GadgetReboot/USB_RS485/GR_USB_RS485_Sch.pdf

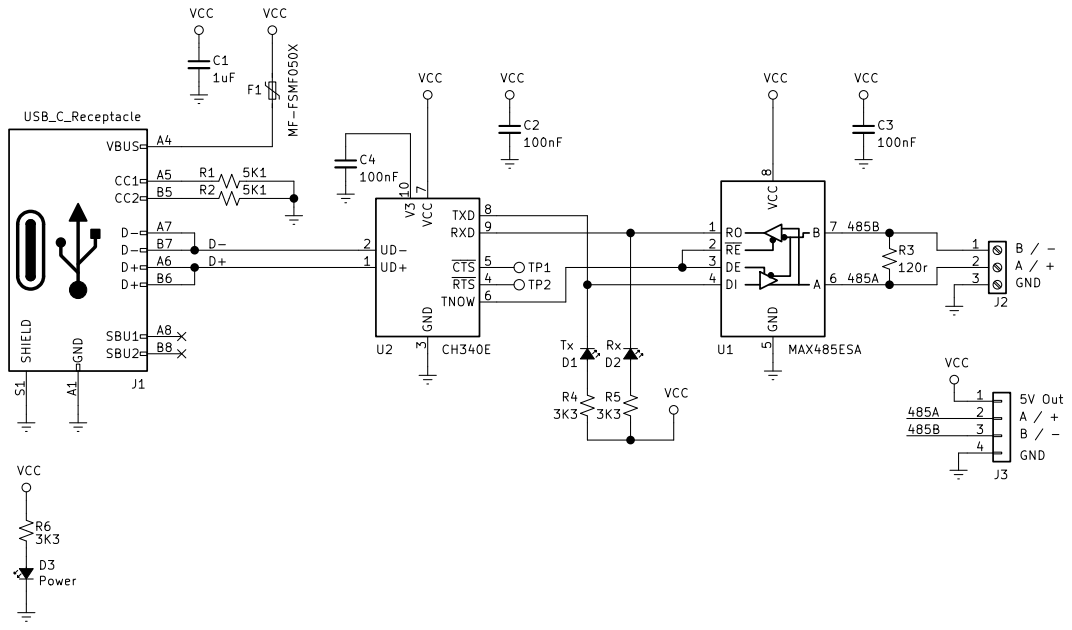
[picture p1: page 1]

7 TXD 8 RXD 9 U2 CH340E RO 1 RE 2 DE 3 DI 4 GND

3 RTS 4 CTS 5 TNOW 6 VCC

https://github.com/GadgetReboot/USB_RS485
https://www.youtube.com/gadgetreboot
File: GR_USB_RS485.sch Sheet: / Gadget Reboot

Id: 1/1 Title: USB to RS485
