GadgetReboot/USB_RS485/KiCad/GR_USB_RS485.kicad_pcb

## KiCad design KiCad/GR_USB_RS485.kicad_pcb (2023-02-17)

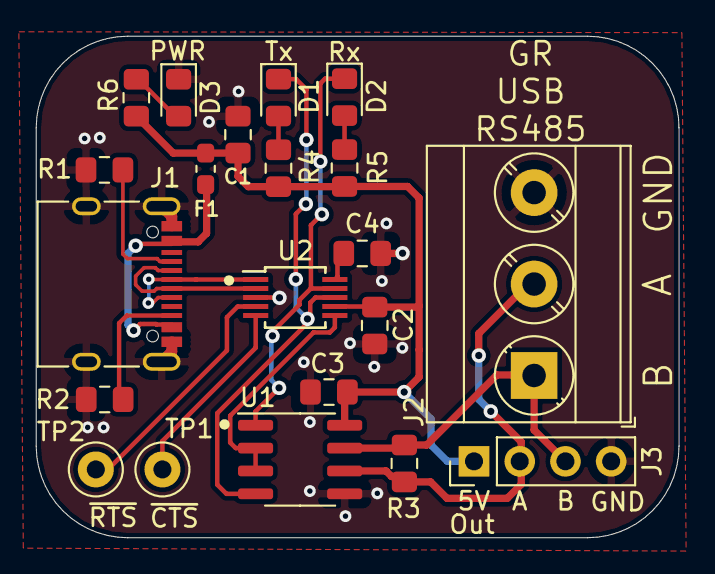
[picture p2: board GR_USB_RS485.kicad_pcb from above]

Board: 2 copper layers, 35.7 x 27.9 mm, 21 parts (0 on the bottom side), 18 nets.

Parts:
C1: 1uF; C_0805_2012Metric_Pad1.15x1.40mm_HandSolder
C2, C3, C4: 100nF; C_0805_2012Metric_Pad1.15x1.40mm_HandSolder
D1: Rx; LED_0805_2012Metric_Pad1.15x1.40mm_HandSolder
D2: Tx; LED_0805_2012Metric_Pad1.15x1.40mm_HandSolder
D3: Power; LED_0805_2012Metric_Pad1.15x1.40mm_HandSolder
F1: MF-FSMF050X; R_0603_1608Metric_Pad1.05x0.95mm_HandSolder
J1: USB_C_Receptacle; USB_C_Receptacle_XKB_U262-16XN-4BVC11
J2: Screw_Terminal_01x03; TerminalBlock_Phoenix_MKDS-3-3-5.08_1x03_P5.08mm_Horizontal
J3: Conn_01x04; PinHeader_1x04_P2.54mm_Vertical
R1, R2: 5K1; R_0805_2012Metric_Pad1.15x1.40mm_HandSolder
R3: 120r; R_0805_2012Metric_Pad1.15x1.40mm_HandSolder
R4, R5, R6: 2K; R_0805_2012Metric_Pad1.15x1.40mm_HandSolder
TP1, TP2: TestPoint; TestPoint_Loop_D1.80mm_Drill1.0mm_Beaded
U1: MAX485ESA; SOIC-8_3.9x4.9mm_P1.27mm
U2: CH340E; MSOP-10_3x3mm_P0.5mm

Connections:
/485A: J2.2, J3.2, R3.2, U1.6
/485B: J2.1, J3.3, R3.1, U1.7
/D+: J1.A6, J1.B6, U2.1
/D-: J1.A7, J1.B7, U2.2
GNDREF: C1.2, C2.2, C3.2, C4.2, D3.1, J1.A1, J1.A12, J1.B1, J1.B12, J1.S1, J2.3, J3.4, R1.1, R2.1, U1.5, U2.3
unnamed: C4.1, U2.10
unnamed: D1.1, U1.4, U2.8
unnamed: D1.2, R4.1
unnamed: D2.1, U1.1, U2.9
unnamed: D2.2, R5.1
unnamed: D3.2, R6.2
unnamed: F1.1, J1.A4, J1.A9, J1.B4, J1.B9
unnamed: J1.A5, R1.2
unnamed: J1.B5, R2.2
unnamed: TP1.1, U2.5
unnamed: TP2.1, U2.4
unnamed: U1.2, U1.3, U2.6
VCC: C1.1, C2.1, C3.1, F1.2, J3.1, R4.2, R5.2, R6.1, U1.8, U2.7
